swifty99/Spotwelderix/PCB/Spotwelderix/Spotwelderix.step

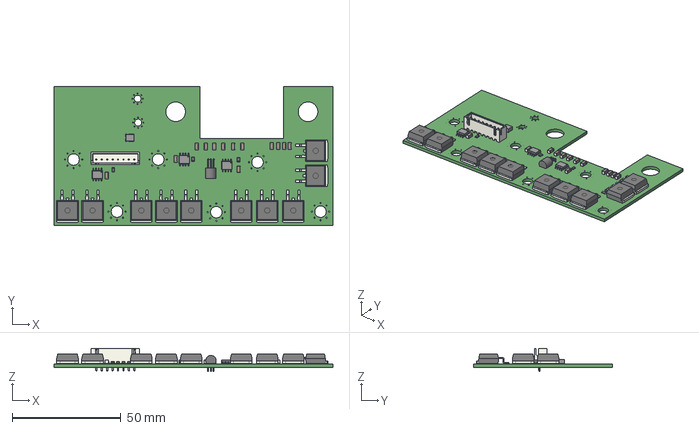
[picture p1: CAD file, 2021-01-31]
PCB/Spotwelderix/Spotwelderix.step
128.5 x 64.2 x 10.6 mm
