swifty99/Spotwelderix/PCB/Spotwelderix-controlboard/Spotwelderix-controlboard.kicad_pcb

## KiCad design PCB/Spotwelderix-controlboard/Spotwelderix-controlboard.kicad_pcb (2022-04-04)

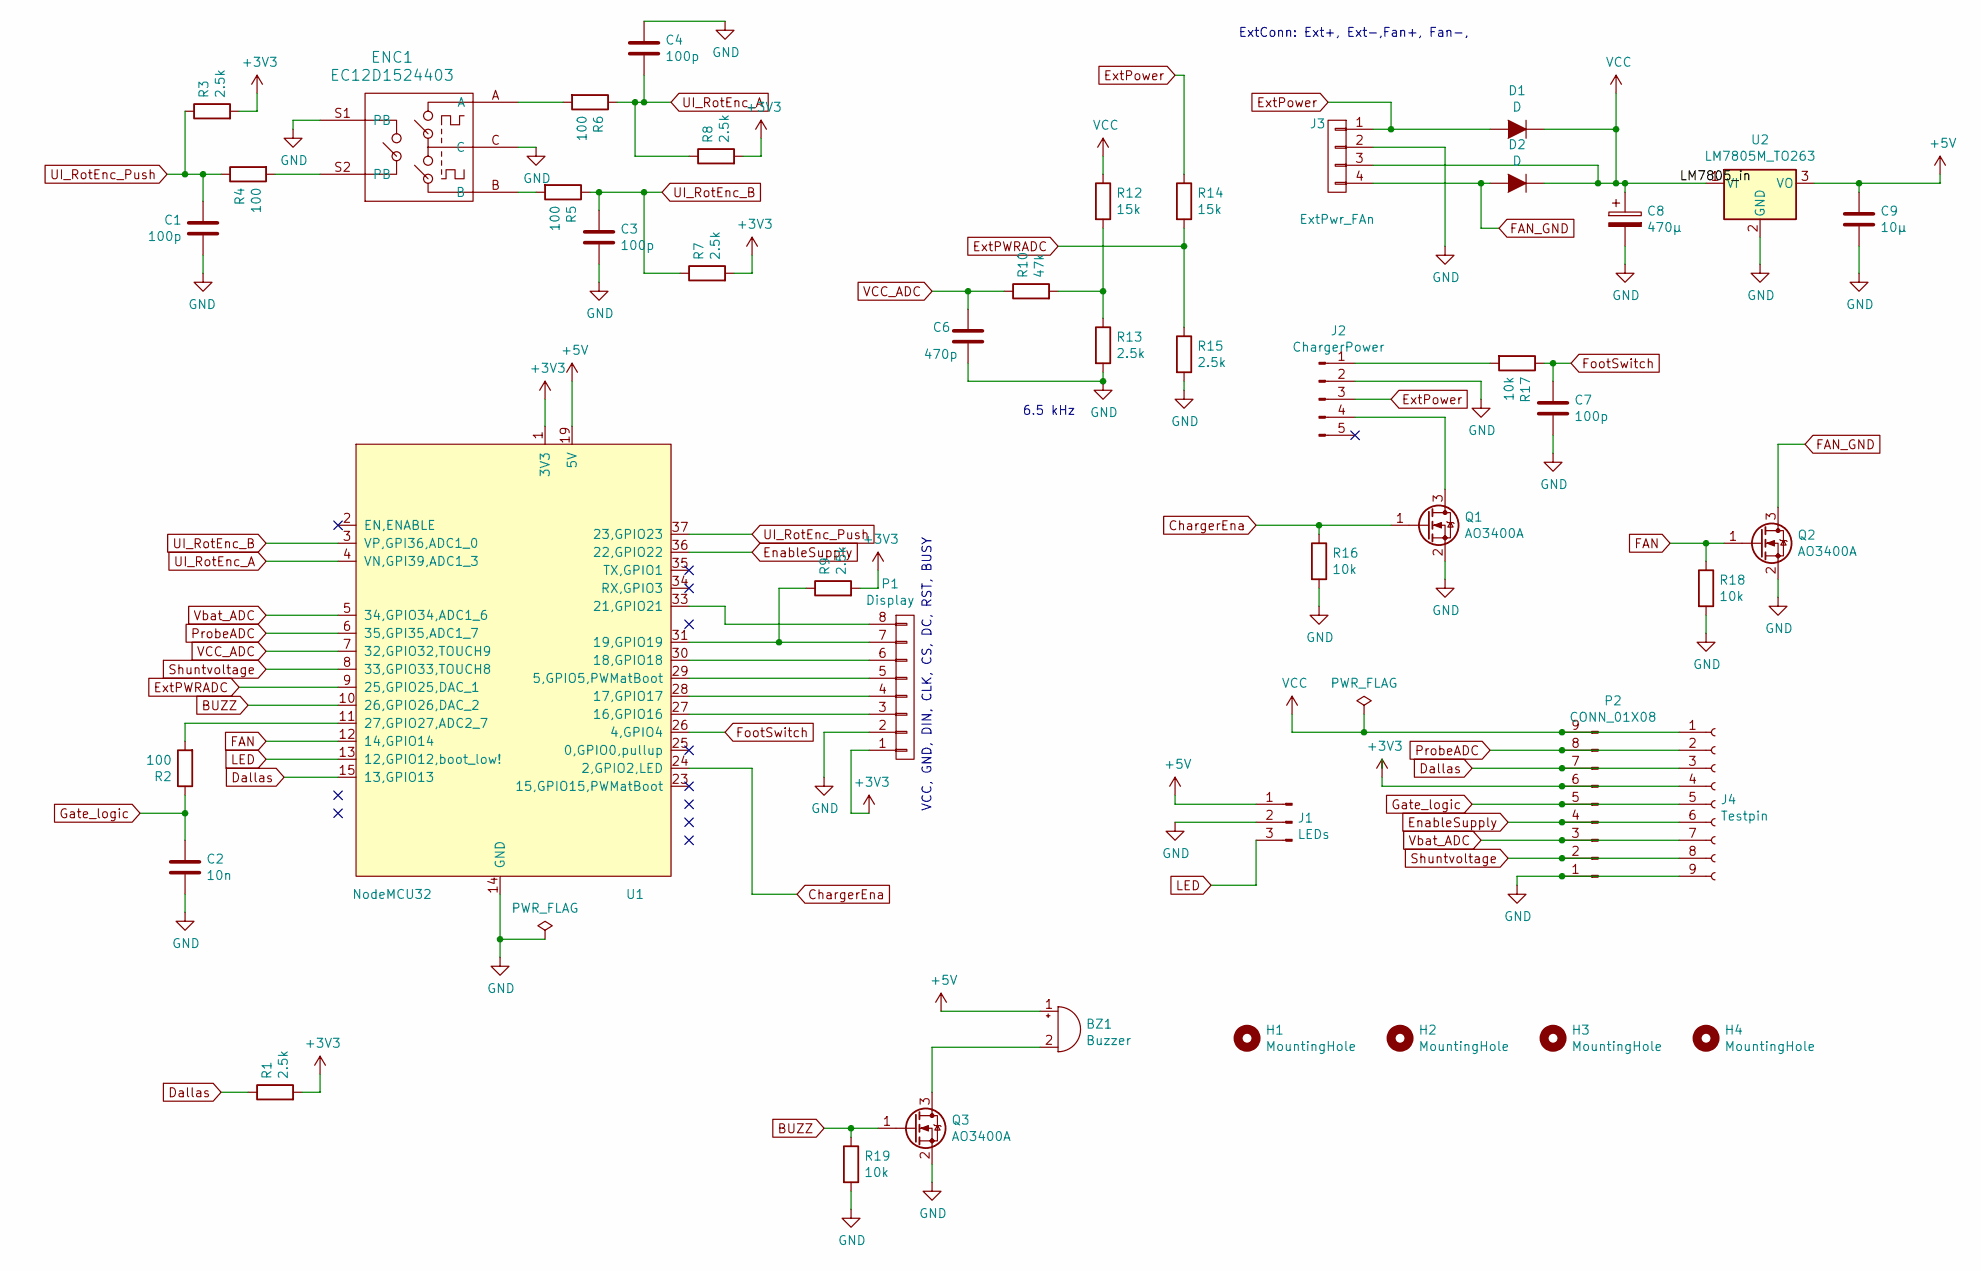
[picture p2: schematic Spotwelderix-controlboard.sch, Spotwelderix Controlboard]

Parts:
BZ1: Buzzer; Buzzer_15x7.5RM7.6
C1, C3, C4: 100p; C_0805_2012Metric
C2: 10n; C_1206_3216Metric_Pad1.33x1.80mm_HandSolder
C6: 470p; C_1206_3216Metric_Pad1.33x1.80mm_HandSolder
C7: 100p; C_1206_3216Metric_Pad1.33x1.80mm_HandSolder
C8: 470µ; CP_Radial_D10.0mm_P5.00mm
C9: 10µ; C_1206_3216Metric_Pad1.33x1.80mm_HandSolder
D1, D2: D; D_SMA_Handsoldering
ENC1: EC12D1524403; RotaryEncoder_Alps_EC12E-Switch_Vertical_H20mm
H1, H2, H3, H4: MountingHole; MountingHole_3.2mm_M3_DIN965_Pad_TopBottom
J1: LEDs; JST_XH_B3B-XH-A_1x03_P2.50mm_Vertical
J2: ChargerPower; JST_XH_B5B-XH-A_1x05_P2.50mm_Vertical
J3: ExtPwr_FAn; JST_XH_B4B-XH-A_1x04_P2.50mm_Vertical
J4: Testpin; PinHeader_1x09_P2.54mm_Vertical
P1: Display; JST_XH_B8B-XH-A_1x08_P2.50mm_Vertical
P2: CONN_01X08; JST_XH_B9B-XH-A_1x09_P2.50mm_Vertical
Q1, Q2, Q3: AO3400A; SOT-23
R1, R3, R7, R8, R9, R13, R15: 2.5k; R_0805_2012Metric
R2, R4, R5, R6: 100; R_0805_2012Metric
R10: 47k; R_0805_2012Metric
R12, R14: 15k; R_0805_2012Metric
R16, R17, R18, R19: 10k; R_0805_2012Metric
U1: NodeMCU32; ESP32_NODEMCU
U2: LM7805M_TO263; TO-252-2

Connections:
BUZZ: Q3.1 (G), R19.1, U1.10 (26,GPIO26,DAC_2)
ChargerEna: Q1.1 (G), R16.1, U1.24 (2,GPIO2,LED)
Dallas: J4.3, P2.7, R1.1, U1.15 (13,GPIO13)
EnableSupply: J4.6, P2.4, U1.36 (22,GPIO22)
ExtPWRADC: R14.2, R15.1, U1.9 (25,GPIO25,DAC_1)
ExtPower: D1.2 (A), J2.3, J3.1, R14.1
FAN: Q2.1 (G), R18.1, U1.12 (14,GPIO14)
FAN_GND: D2.2 (A), J3.4, Q2.3 (D)
FootSwitch: C7.1, R17.1, U1.26 (4,GPIO4)
GND: C1.2, C2.2, C3.2, C4.1, C6.2, C7.2, C8.2, C9.2, ENC1.C, ENC1.S1 (PB), J1.2, J2.2, J3.2, J4.9, P1.2, P2.1, Q1.2 (S), Q2.2 (S), Q3.2 (S), R13.2, R15.2, R16.2, R18.2, R19.2, U1.14 (GND), U1.38 (GND), U2.2 (GND)
Gate_logic: C2.1, J4.5, P2.5, R2.1
LED: J1.3, U1.13 (12,GPIO12,boot_low!)
unnamed: BZ1.2 (+), Q3.3 (D)
unnamed: ENC1.A, R6.2
unnamed: ENC1.B, R5.2
unnamed: ENC1.S2 (PB), R4.2
unnamed: J2.1, R17.2
unnamed: J2.4, Q1.3 (D)
unnamed: P1.3, U1.27 (16,GPIO16)
unnamed: P1.4, U1.28 (17,GPIO17)
unnamed: P1.5, U1.29 (5,GPIO5,PWMatBoot)
unnamed: P1.6, U1.30 (18,GPIO18)
unnamed: P1.7, R9.1, U1.31 (19,GPIO19)
unnamed: P1.8, U1.33 (21,GPIO21)
unnamed: R2.2, U1.11 (27,GPIO27,ADC2_7)
unnamed: R10.2, R12.2, R13.1
ProbeADC: J4.2, P2.8, U1.6 (35,GPI35,ADC1_7)
Probe_diff: J4.7, P2.3, U1.5 (34,GPIO34,ADC1_6); also elsewhere on the board
Shuntvoltage: J4.8, P2.2, U1.8 (33,GPIO33,TOUCH8)
UI_RotEnc_A: C4.2, R6.1, R8.1, U1.4 (VN,GPI39,ADC1_3)
UI_RotEnc_B: C3.1, R5.1, R7.1, U1.3 (VP,GPI36,ADC1_0)
UI_RotEnc_Push: C1.1, R3.1, R4.1, U1.37 (23,GPIO23)
VCC: C8.1, D1.1 (K), D2.1 (K), J3.3, J4.1, P2.9, R12.1, U2.1 (VI)
VCC_ADC: C6.1, R10.1, U1.7 (32,GPIO32,TOUCH9)

Notes on the sheet:
ExtConn: Ext+, Ext-,Fan+, Fan-,
6.5 kHz
VCC, GND, DIN, CLK, CS, DC, RST, BUSY

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
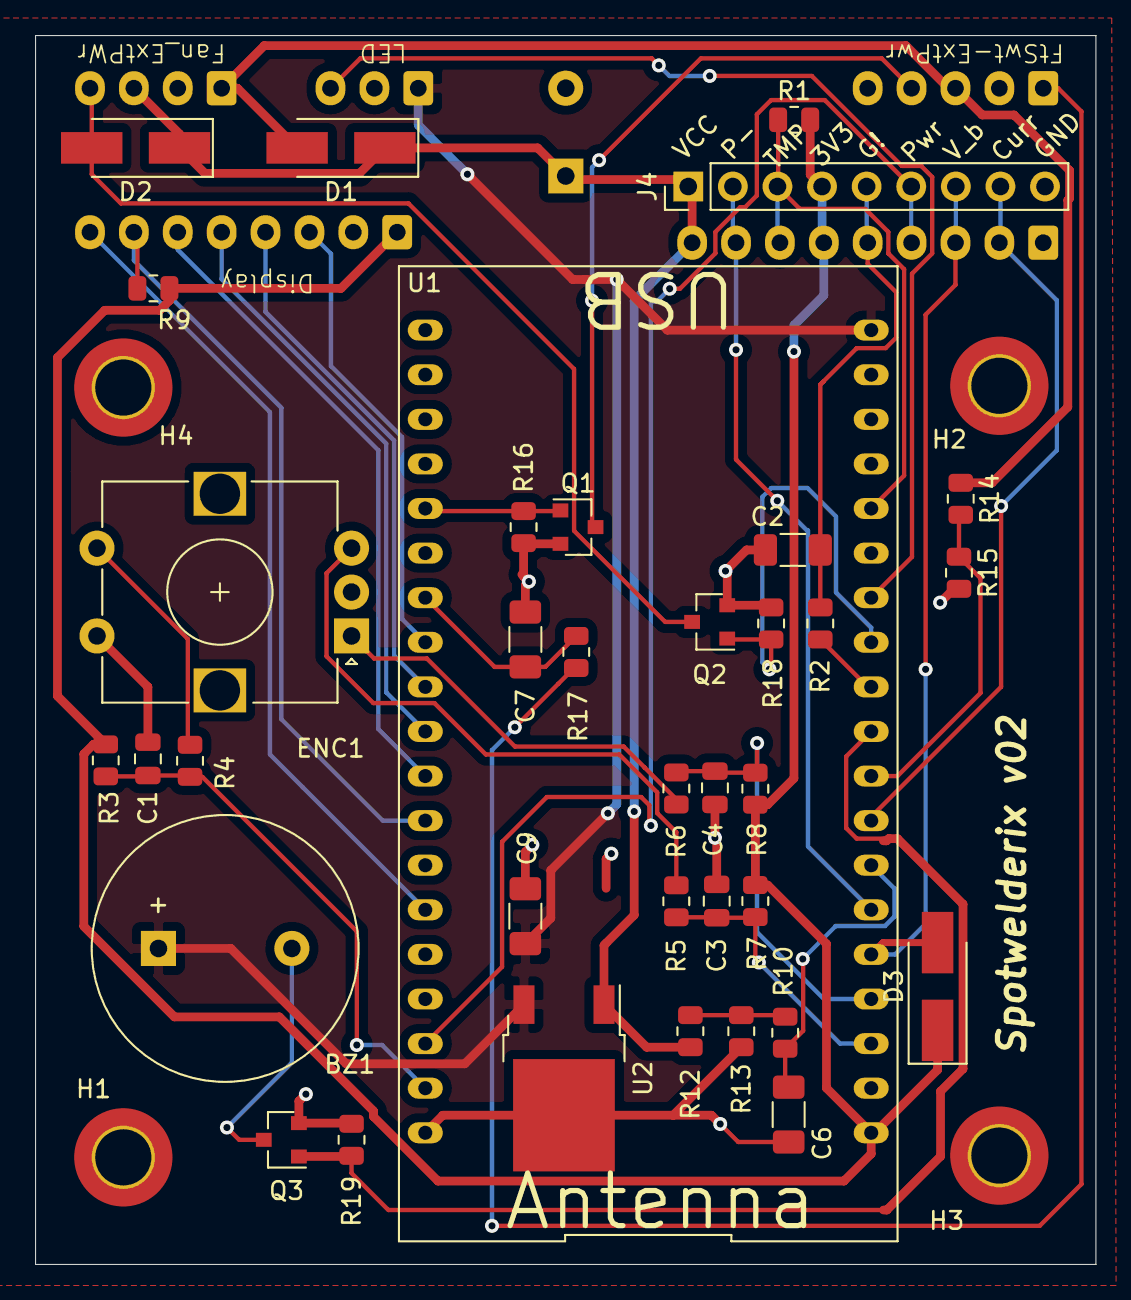
[picture p3: board Spotwelderix-controlboard.kicad_pcb from above]

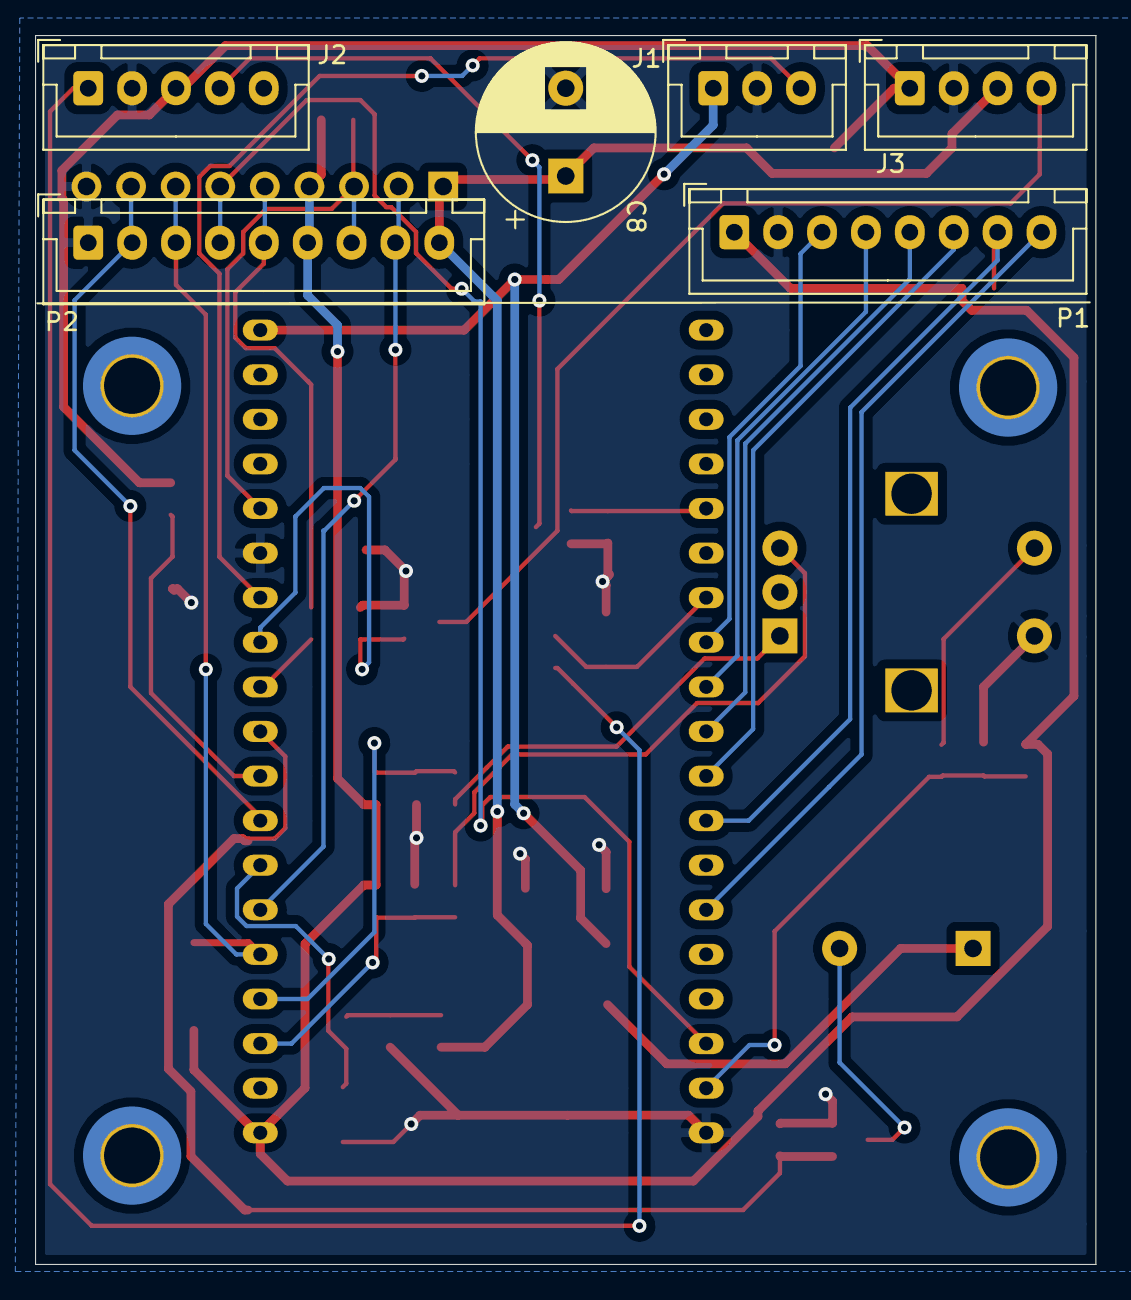
[picture p4: board Spotwelderix-controlboard.kicad_pcb from below]

Board: 2 copper layers, 60.4 x 70.0 mm, 46 parts (6 on the bottom side), 36 nets.

Other parts of the board:
D3: D_Schottky; D_SMA_Handsoldering

Their connections:
Probe_diff: D3.2; also elsewhere on the board
