swifty99/Spotwelderix/PCB/Spotwelderix/Spotwelderix.kicad_pcb

## KiCad design PCB/Spotwelderix/Spotwelderix.kicad_pcb (2022-04-04)

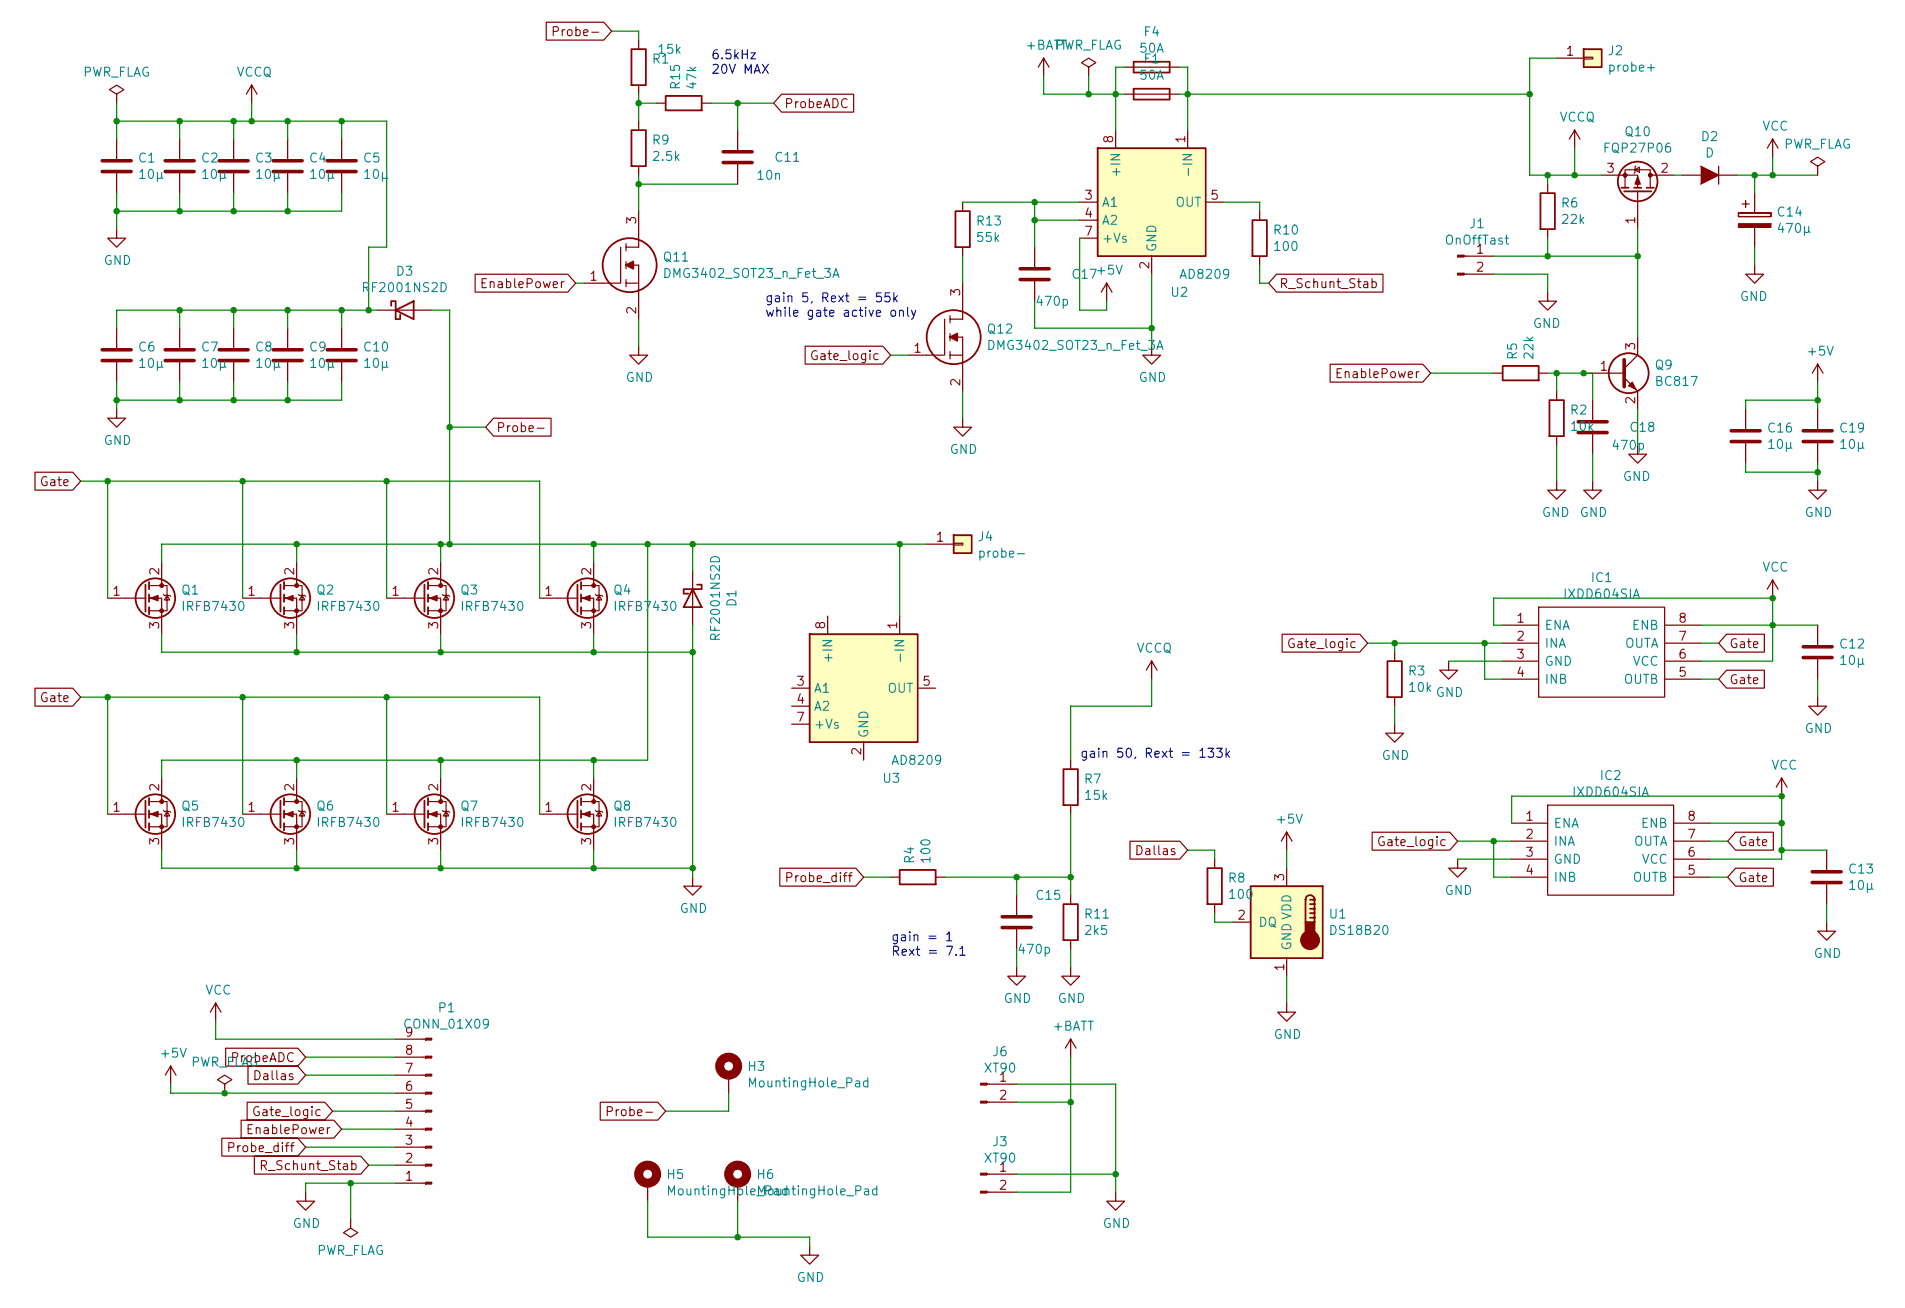
[picture p5: schematic Spotwelderix.sch, Spotwelderix PowerPCB]

Parts:
C1, C2, C3, C4, C5, C6, C7, C8, C9, C10, C12, C13, C16, C19: 10µ; C_1206_3216Metric
C11: 10n; C_0805_2012Metric_Pad1.18x1.45mm_HandSolder
C14: 470µ; CP_Radial_D10.0mm_P5.00mm
C15, C17, C18: 470p; C_0805_2012Metric_Pad1.18x1.45mm_HandSolder
D1, D3: RF2001NS2D; TO-263-2_TabPin1
D2: D; D_SMA_Handsoldering
F1, F4: 50A; Blade_Fuse_maxi_handsolder_1.5drill
H3, H5, H6: MountingHole_Pad; MountingHole_4.3mm_M4_Pad_Via
IC1, IC2: IXDD604SIA; SOIC127P600X175-8N; Mouser Part Number 849-IXDD604SIA
J1: OnOffTast; JST_XH_S2B-XH-A_1x02_P2.50mm_Horizontal
J2: probe+; MountingHole_5.3mm_M5_Pad_Via
J3, J6: XT90; AMASS_XT60-M_1x02_P7.20mm_Vertical
J4: probe-; MountingHole_5.3mm_M5_Pad_Via
P1: CONN_01X09; JST_XH_B9B-XH-A_1x09_P2.50mm_Vertical
Q1, Q2, Q3, Q4, Q5, Q6, Q7, Q8: IRFB7430; TO-263-2
Q9: BC817; SOT-23
Q10: FQP27P06; TO-220-3_Horizontal_TabDown
Q11, Q12: DMG3402_SOT23_n_Fet_3A; SOT-23_Handsoldering
R1, R7: 15k; R_0805_2012Metric
R2, R3: 10k; R_0805_2012Metric
R4, R8, R10: 100; R_0805_2012Metric
R5, R6: 22k; R_0805_2012Metric
R9: 2.5k; R_0805_2012Metric
R11: 2k5; R_0805_2012Metric
R13: 55k; R_0805_2012Metric
R15: 47k; R_0805_2012Metric
U1: DS18B20; TO-92_Inline_Horizontal1
U2, U3: AD8209; MSOP-8_3x3mm_P0.65mm

Connections:
+5V: C16.1, C19.1, P1.6, U1.3 (VDD), U2.7 (+Vs)
+BATT: F1.2, F4.2, J3.2, J6.2, U2.8 (+IN)
Dallas: P1.7, R8.1
EnablePower: P1.4, Q11.1, R5.1
GND: C1.2, C2.2, C3.2, C4.2, C5.2, C6.2, C7.2, C8.2, C9.2, C10.2, C12.2, C13.2, C14.2, C15.2, C16.2, C17.2, C18.2, C19.2, D1.2 (A), H5.1, H6.1, IC1.3 (GND), IC2.3 (GND), J1.2, J3.1, J6.1, P1.1, Q1.3 (S), Q2.3 (S), Q3.3 (S), Q4.3 (S), Q5.3 (S), Q6.3 (S), Q7.3 (S), Q8.3 (S), Q9.2 (E), Q11.2, Q12.2, R2.2, R3.2, R11.2, U1.1 (GND), U2.2 (GND)
Gate: IC1.5 (OUTB), IC1.7 (OUTA), IC2.5 (OUTB), IC2.7 (OUTA), Q1.1 (G), Q2.1 (G), Q3.1 (G), Q4.1 (G), Q5.1 (G), Q6.1 (G), Q7.1 (G), Q8.1 (G)
Gate_logic: IC1.2 (INA), IC1.4 (INB), IC2.2 (INA), IC2.4 (INB), P1.5, Q12.1, R3.1
unnamed: C11.2, Q11.3, R9.2
unnamed: C15.1, R4.2, R7.2, R11.1
unnamed: C17.1, R13.1, U2.3 (A1), U2.4 (A2)
unnamed: C18.1, Q9.1 (B), R2.1, R5.2
unnamed: D2.2 (A), Q10.2 (D)
unnamed: J1.1, Q9.3 (C), Q10.1 (G), R6.2
unnamed: Q12.3, R13.2
unnamed: R1.2, R9.1, R15.1
unnamed: R8.2, U1.2 (DQ)
unnamed: R10.1, U2.5 (OUT)
Probe-: D1.1 (K), D3.2 (A), H3.1, J4.1, Q1.2 (D), Q2.2 (D), Q3.2 (D), Q4.2 (D), Q5.2 (D), Q6.2 (D), Q7.2 (D), Q8.2 (D), R1.1, U3.1 (-IN)
ProbeADC: C11.1, P1.8, R15.2
Probe_diff: P1.3, R4.1
R_Schunt_Stab: P1.2, R10.2
VCC: C12.1, C13.1, C14.1, D2.1 (K), IC1.1 (ENA), IC1.6 (VCC), IC1.8 (ENB), IC2.1 (ENA), IC2.6 (VCC), IC2.8 (ENB), P1.9
VCCQ: C1.1, C2.1, C3.1, C4.1, C5.1, C6.1, C7.1, C8.1, C9.1, C10.1, D3.1 (K), F1.1, F4.1, J2.1, Q10.3 (S), R6.1, R7.1, U2.1 (-IN)

Notes on the sheet:
gain 5, Rext = 55k while gate active only
6.5kHz 20V MAX
gain 50, Rext = 133k
gain = 1 Rext = 7.1

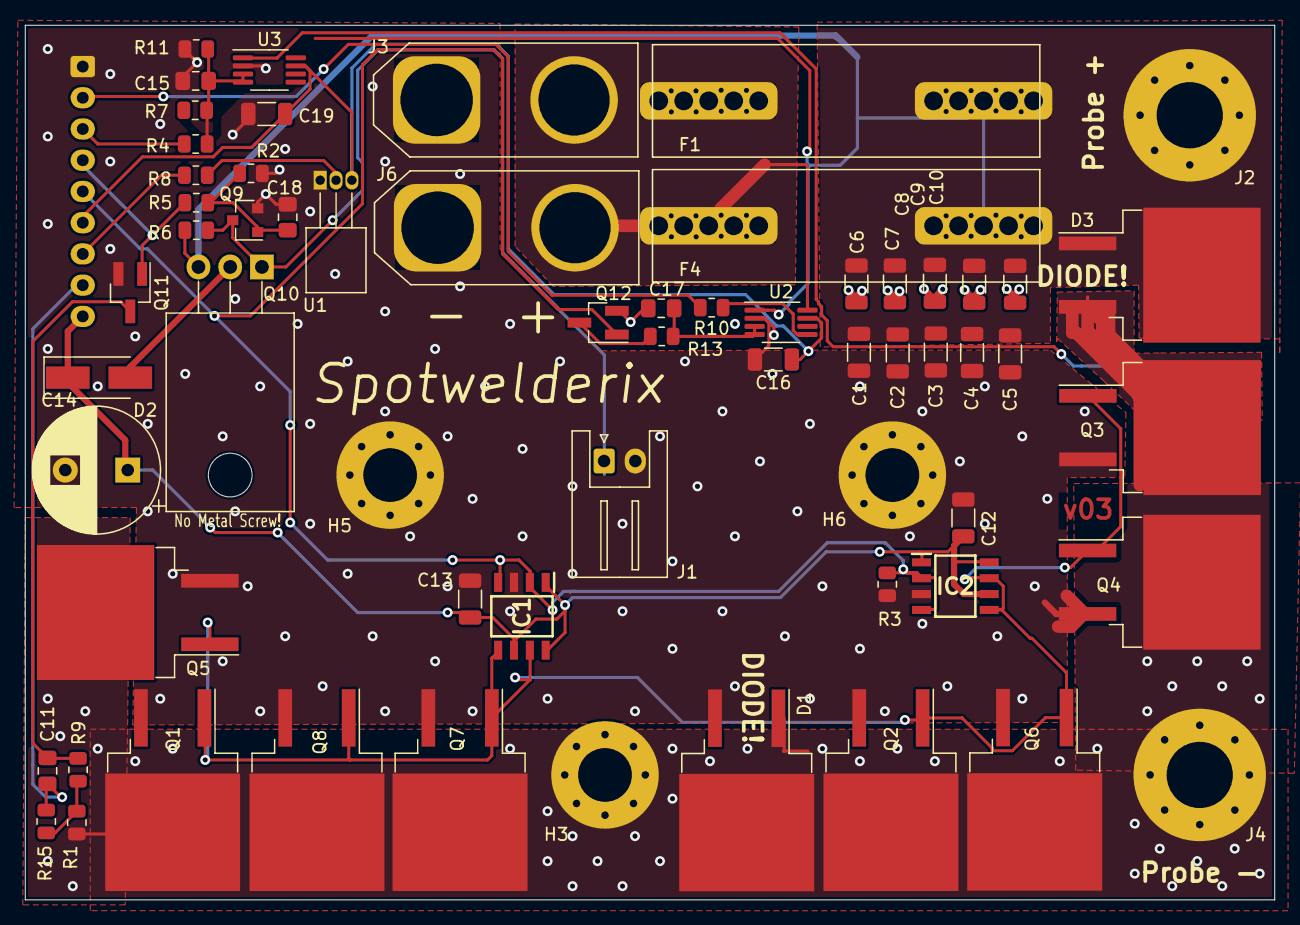
[picture p6: board Spotwelderix.kicad_pcb from above]

Board: 2 copper layers, 100.0 x 70.0 mm, 63 parts (1 on the bottom side), 23 nets.
