swifty99/Spotwelderix/PCB/Spotwelderix/Spotwelderix.kicad_pcb_vias.kicad_pcb

## KiCad design PCB/Spotwelderix/Spotwelderix.kicad_pcb_vias.kicad_pcb (2021-01-31)

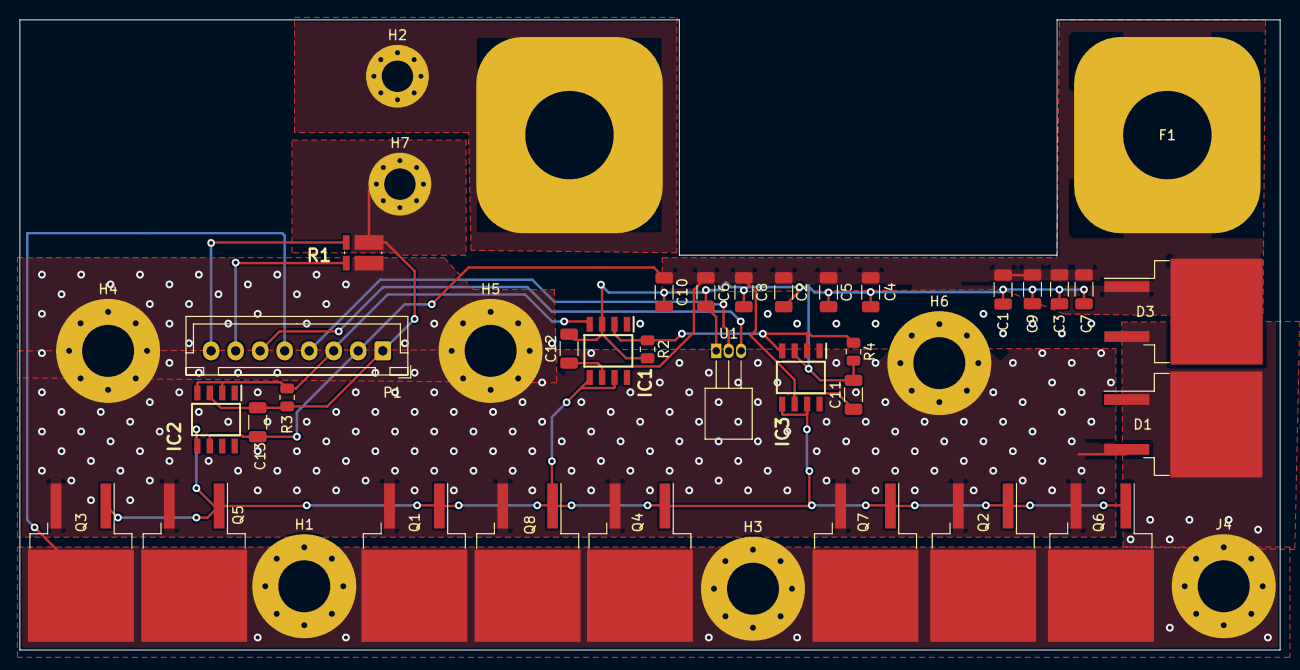
[picture p7: board Spotwelderix.kicad_pcb_vias.kicad_pcb from above]

Board: 2 copper layers, 128.5 x 64.2 mm, 41 parts (0 on the bottom side), 11 nets.

Parts:
C1, C2, C3, C4, C5, C6, C7, C8, C9, C10, C11, C12, C13: 10µ; C_1206_3216Metric
D1, D3: RF2001NS2D; TO-263-2_TabPin1
F1: 300A; ANL_Fuse
H1, H3, H4, H5, H6: MountingHole_Pad; MountingHole_5.3mm_M5_Pad_Via
H2, H7: MountingHole_Pad; MountingHole_3.2mm_M3_Pad_Via
IC1, IC2, IC3: IXDD604SIA; SOIC127P600X175-8N
J4: probe-; MountingHole_5.3mm_M5_Pad_Via
P1: CONN_01X08; JST_XH_B8B-XH-A_1x08_P2.50mm_Vertical
Q1, Q2, Q3, Q4, Q5, Q6, Q7, Q8: IRFB7430; TO-263-2
R1: R_Shunt; WSK12161L000FEA
R2, R3, R4: 10k; R_0805_2012Metric
U1: DS18B20; TO-92_Inline_Horizontal1

Connections:
+5V: P1.6, U1.3
+BATT: F1.2, H2.1
Dallas: P1.4, U1.2
FET_GND: D1.2, H4.1, H5.1, H6.1, Q1.3, Q2.3, Q3.3, Q4.3, Q5.3, Q6.3, Q7.3, Q8.3, R1.4
GND: C1.2, C2.2, C3.2, C4.2, C5.2, C6.2, C7.2, C8.2, C9.2, C10.2, C11.2, C12.2, C13.2, H7.1, IC1.3, IC2.3, IC3.3, P1.1, R1.1, R2.2, R3.2, R4.2, U1.1
Gate: IC1.5, IC1.7, IC2.5, IC2.7, IC3.5, IC3.7, Q1.1, Q2.1, Q3.1, Q4.1, Q5.1, Q6.1, Q7.1, Q8.1
Gate_logic: IC1.2, IC1.4, IC2.2, IC2.4, IC3.2, IC3.4, P1.3, R2.1, R3.1, R4.1
Probe-: D1.1, D3.2, H1.1, H3.1, J4.1, P1.5, Q1.2, Q2.2, Q3.2, Q4.2, Q5.2, Q6.2, Q7.2, Q8.2
R_Schunt_H: P1.7, R1.3
R_Schunt_L: P1.8, R1.2
VCC: C1.1, C2.1, C3.1, C4.1, C5.1, C6.1, C7.1, C8.1, C9.1, C10.1, C11.1, C12.1, C13.1, D3.1, F1.1, IC1.6, IC2.6, IC3.6, P1.2
