swifty99/Spotwelderix/(commit log)

2021-01-31 power pcb added
    [Spotwelderix-controlboard.kicad_pcb, Spotwelderix-controlboard.sch, Spotwelderix.kicad_pcb, Spotwelderix.sch]
2021-01-31 power pcb updated, added safe power for driver
    [Spotwelderix-B_Cu.gbr, Spotwelderix-B_Mask.gbr, Spotwelderix-B_Paste.gbr, Spotwelderix-B_SilkS.gbr, Spotwelderix-Edge_Cuts.gbr, Spotwelderix-F_Cu.gbr, Spotwelderix-F_Mask.gbr, Spotwelderix-F_Paste.gbr]
2021-02-02 ena powerpcb added
    [Spotwelderix-controlboard.kicad_pcb, Spotwelderix-controlboard.sch, Spotwelderix.kicad_pcb, Spotwelderix.sch]
2021-02-03 shunt replace
    [Spotwelderix.kicad_pcb, Spotwelderix.sch, calc shunt.xlsx]
2021-02-04 ordered version v01
    [Spotwelderix-B_Cu.gbr, Spotwelderix-B_Mask.gbr, Spotwelderix-B_Paste.gbr, Spotwelderix-B_SilkS.gbr, Spotwelderix-Edge_Cuts.gbr, Spotwelderix-F_Cu.gbr, Spotwelderix-F_Mask.gbr, Spotwelderix-F_Paste.gbr]
2021-02-05 ordered seperately
    [Spotwelderix-B_Cu.gbr, Spotwelderix-B_Mask.gbr, Spotwelderix-B_SilkS.gbr, Spotwelderix-Edge_Cuts.gbr, Spotwelderix-F_Cu.gbr, Spotwelderix-F_Mask.gbr, Spotwelderix-F_Paste.gbr, Spotwelderix-F_SilkS.gbr]
2021-08-27 pcb update 1.9
    [Spotwelderix-controlboard.csv, Spotwelderix-controlboard.kicad_pcb, Spotwelderix-controlboard.sch, Spotwelderix.csv, Spotwelderix.kicad_pcb, Spotwelderix.sch]
2021-08-29 PCB v2 , Power PCB routed
    [Spotwelderix-controlboard.sch, Spotwelderix.kicad_pcb, Spotwelderix.sch]
2021-08-29 clean up
    [Spotwelderix-controlboard.sch, Spotwelderix.kicad_pcb, Spotwelderix.sch]
2021-09-01 V2 tweaks and tricks
    Voltmeasure enable
    [Spotwelderix-controlboard.kicad_pcb, Spotwelderix-controlboard.sch, Spotwelderix.kicad_pcb, Spotwelderix.sch]
2021-09-01 connector sideflip
    [Spotwelderix.kicad_pcb, Spotwelderix.sch]
2021-09-01 mount hole m4
    [Spotwelderix-controlboard.sch, Spotwelderix.kicad_pcb, Spotwelderix.sch]
2021-10-18 SW auto calibrate batt volt
    [Spotwelderix (2).csv, Spotwelderix-controlboard (2).csv, Spotwelderix-controlboard (3).csv, Spotwelderix-controlboard (4).csv, Spotwelderix.sch]
2022-04-01 v3 commissioning
    v3 has updated measurment devices to allow measurment of 1kA and voltages down to 0.3V accurately. Measeure the short!
    [Spotwelderix v3.csv, Spotwelderix-controlboard.kicad_pcb, Spotwelderix-controlboard.sch, Spotwelderix.kicad_pcb]
2022-04-04 auto weld, non functional
    [Spotwelderix.sch]
2022-04-04 working display
    [Spotwelderix v3.csv, Spotwelderix-controlboard.kicad_pcb, Spotwelderix-controlboard.sch, Spotwelderix.kicad_pcb]
2022-04-10 Resistance measure
