swifty99/Spotwelderix/(notices)

Notices in the files:
PCB/Spotwelderix-controlboard/Spotwelderix-controlboard.sch:
license: https://creativecommons.org/licenses/by/4.0
